LeoKevinKR/AVR-GearGauge/(commit log)

2018-10-03 Revert "Initial commit"
    This reverts commit 7f692b8d3bae7875543c362c1527e458e2e07246.
    [MySettings.h]
2018-10-03 Revert "Revert "Initial commit""
    This reverts commit cb0f5f5613197cab9b7d66ad65dee47719bb3121.
    [MySettings.h]
